opensolar/OpenOne/hall_pcb/HallPCB.JPG

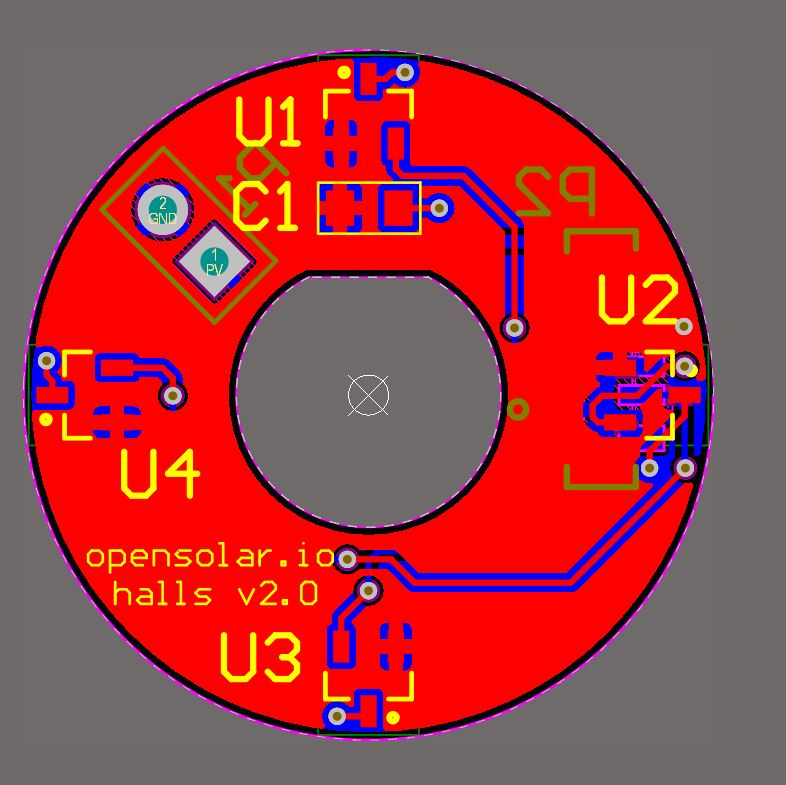
hall_pcb/HallPCB.JPG
