opensolar/OpenOne/main_pcb/alim_3.JPG

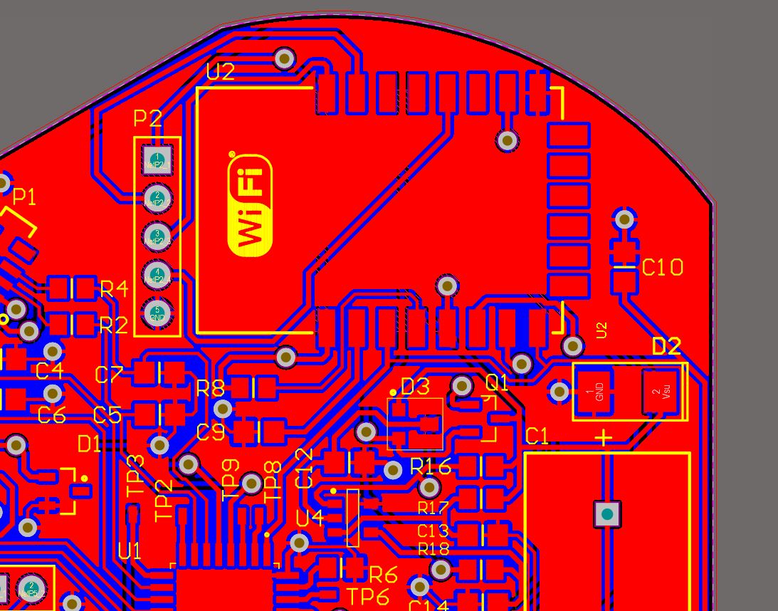
main_pcb/alim_3.JPG
