opensolar/OpenOne/ESP_firmware/openone_esp/readme.txt

setup arduino:

File/preferences:
Additional Board Manager URLS:https://arduino.esp8266.com/stable/package_esp8266com_index.json

Manage library:
ArduinoJson  (Benoit Blanchon 6.19.4)
PubSubClient (Nick O'Leary 2.8.0)

Créer un fichier credentials.h dans le meme dossier que le sketch:
//const char* ssid = "my_ssid";
//const char* password = "my_password";
//const char* mqtt_server = "technolaf.com:1883";
