opensolar/OpenOne/hall_pcb/HallPCB_3d.JPG

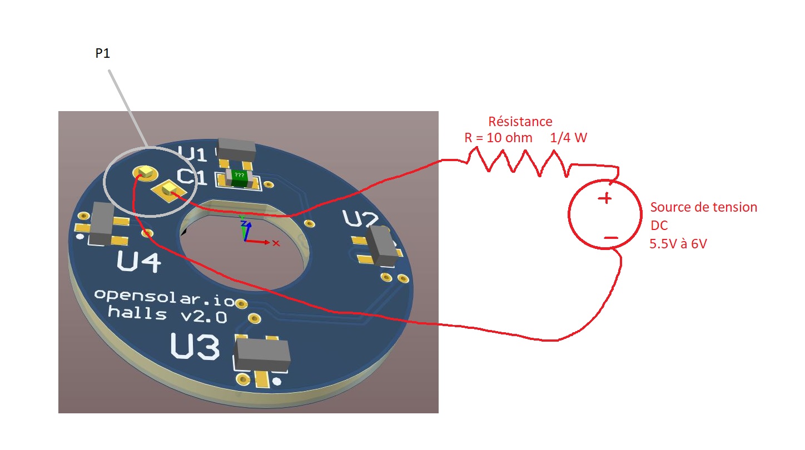
hall_pcb/HallPCB_3d.JPG
