opensolar/OpenOne/hall_pcb/HallPCB_supply.jpg

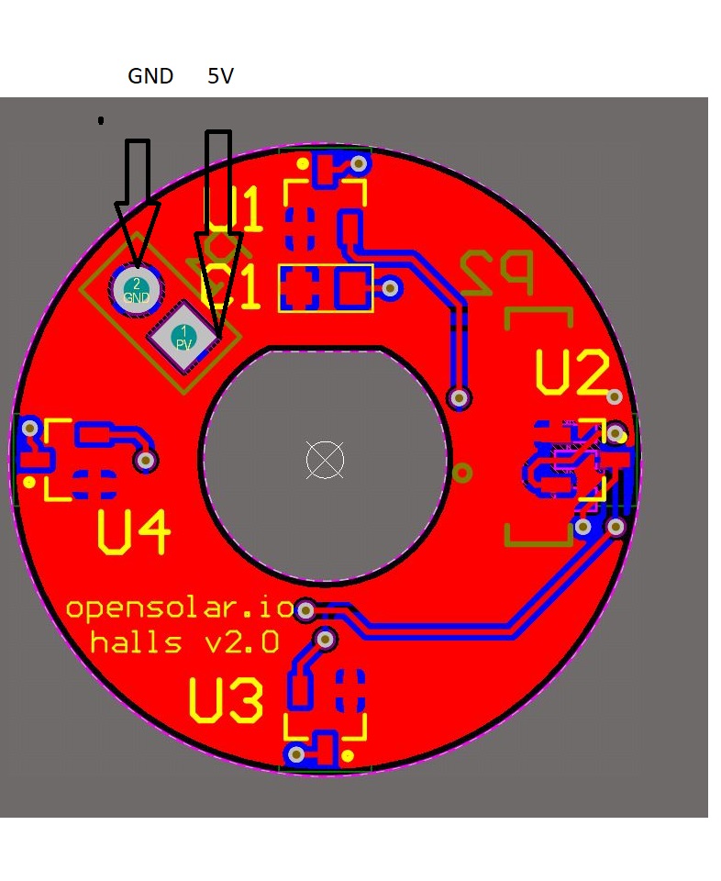
hall_pcb/HallPCB_supply.jpg
