opensolar/OpenOne/main_pcb/alim_1.JPG

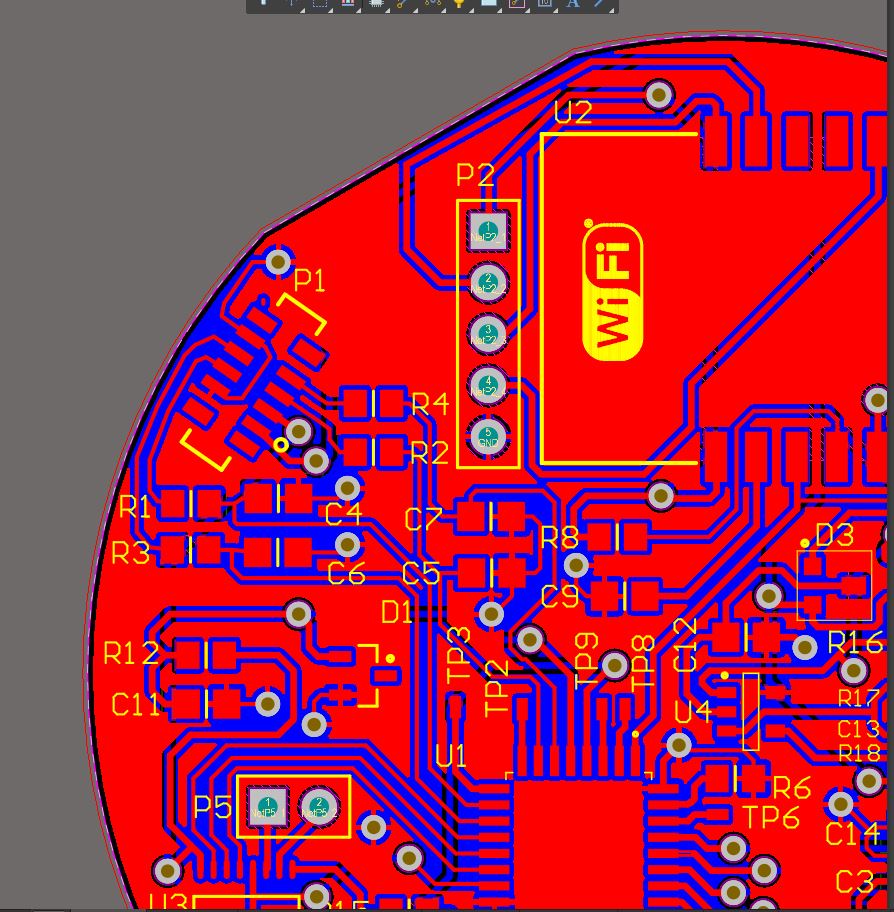
main_pcb/alim_1.JPG
