opensolar/OpenOne/main_pcb/alim_2.JPG

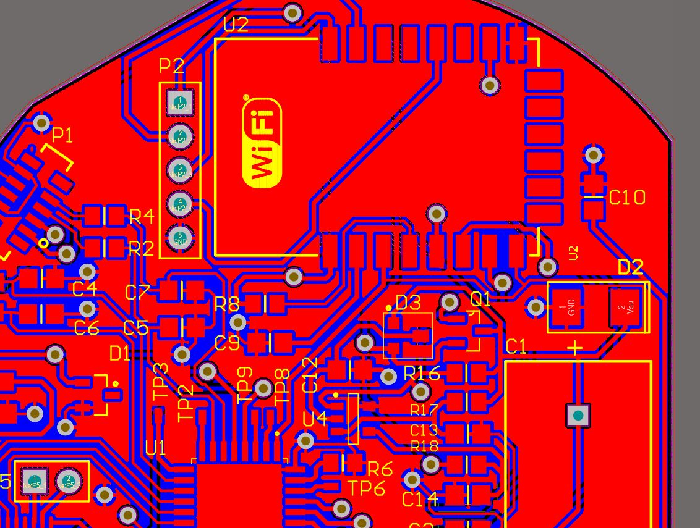
main_pcb/alim_2.JPG
