opensolar/OpenOne/main_pcb/alim_4.JPG

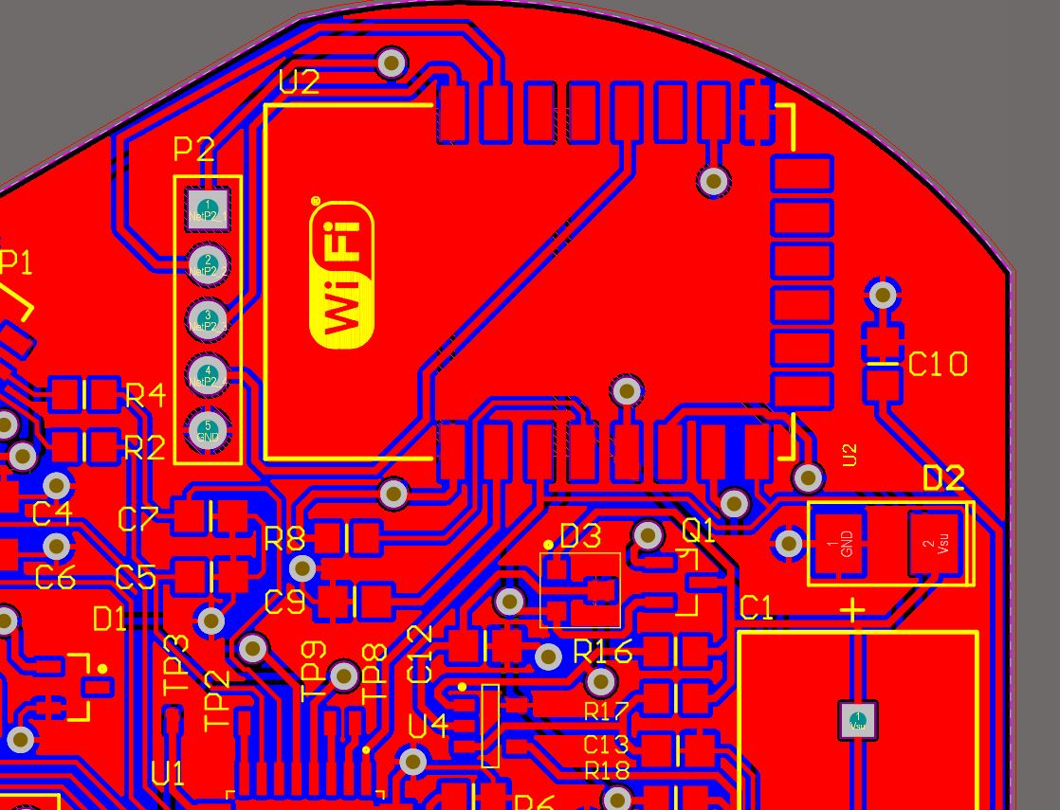
main_pcb/alim_4.JPG
