opensolar/OpenOne/main_pcb/esp12e.JPG

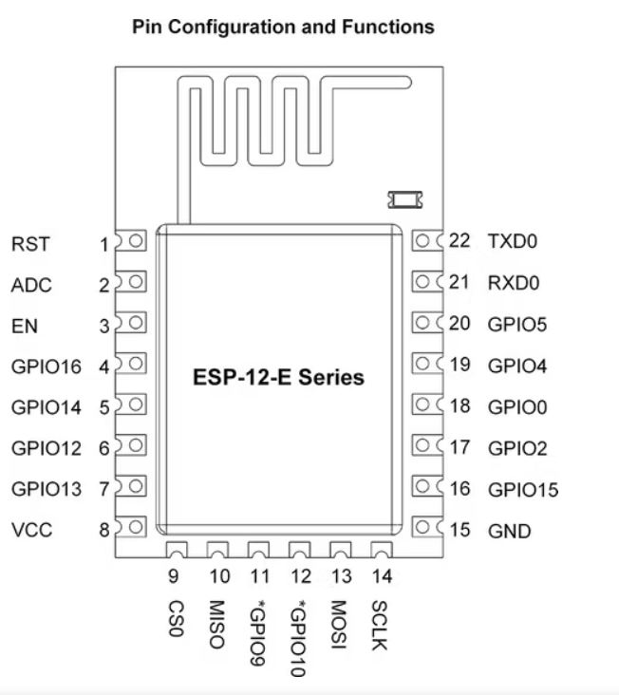
main_pcb/esp12e.JPG
