opensolar/OpenOne/main_pcb/MainPCB.JPG

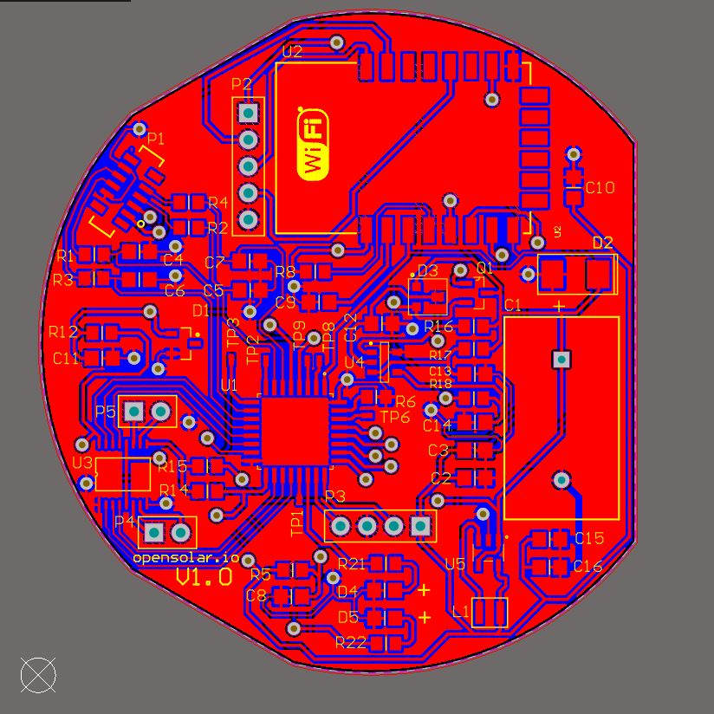
main_pcb/MainPCB.JPG
