opensolar/OpenOne/main_pcb/modif_motor_driver.PNG

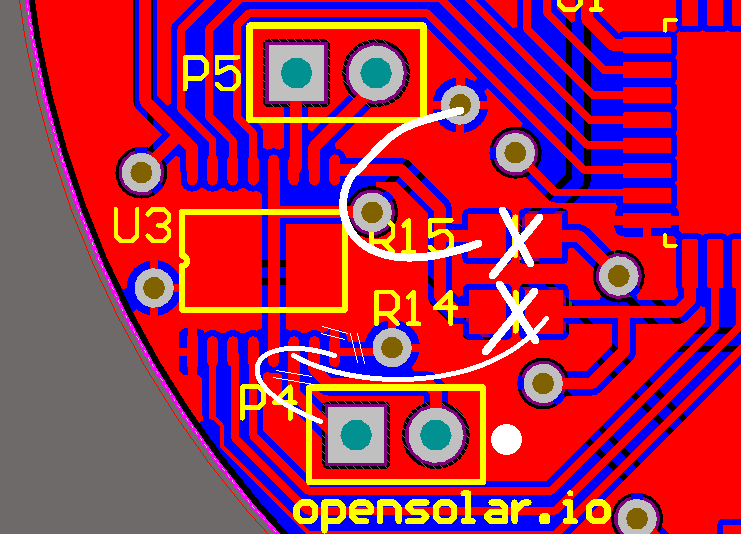
main_pcb/modif_motor_driver.PNG
