opensolar/OpenOne/main_pcb/modif_swap_ss_blueled.PNG

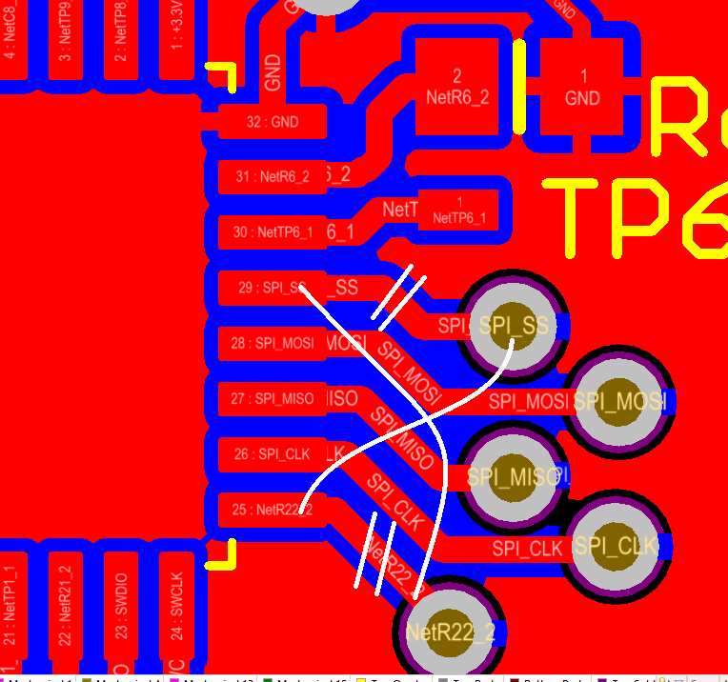
main_pcb/modif_swap_ss_blueled.PNG
