opensolar/OpenOne/main_pcb/STM32L011K4T6.JPG

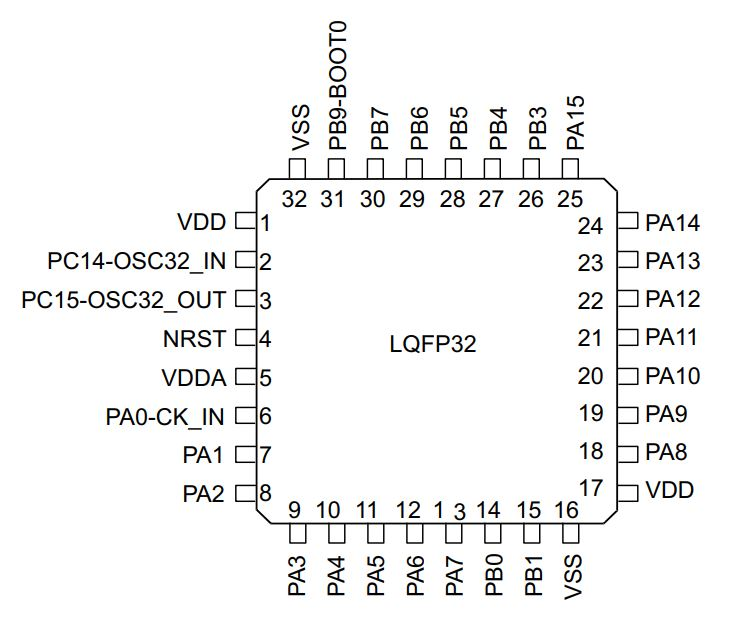
main_pcb/STM32L011K4T6.JPG
