opensolar/OpenOne/sun_angle_calculations/analemma_13h.png

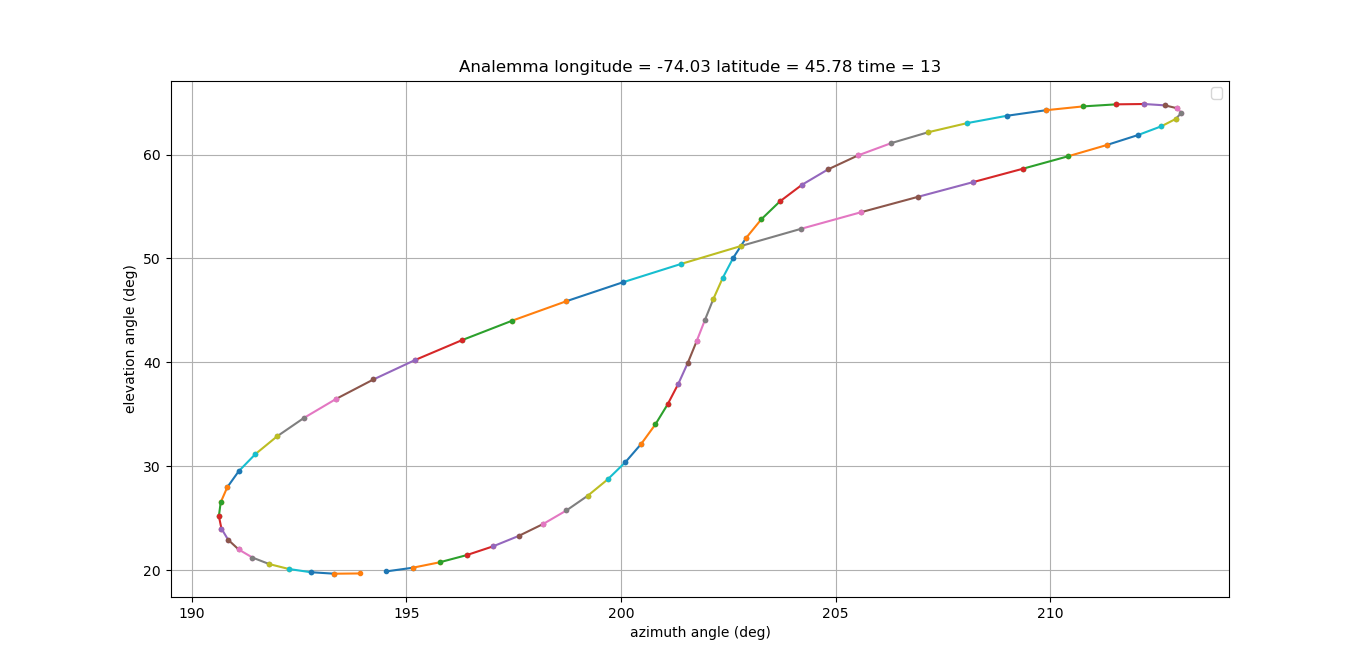
sun_angle_calculations/analemma_13h.png
