opensolar/OpenOne/sun_angle_calculations/analemma_different_cities.png

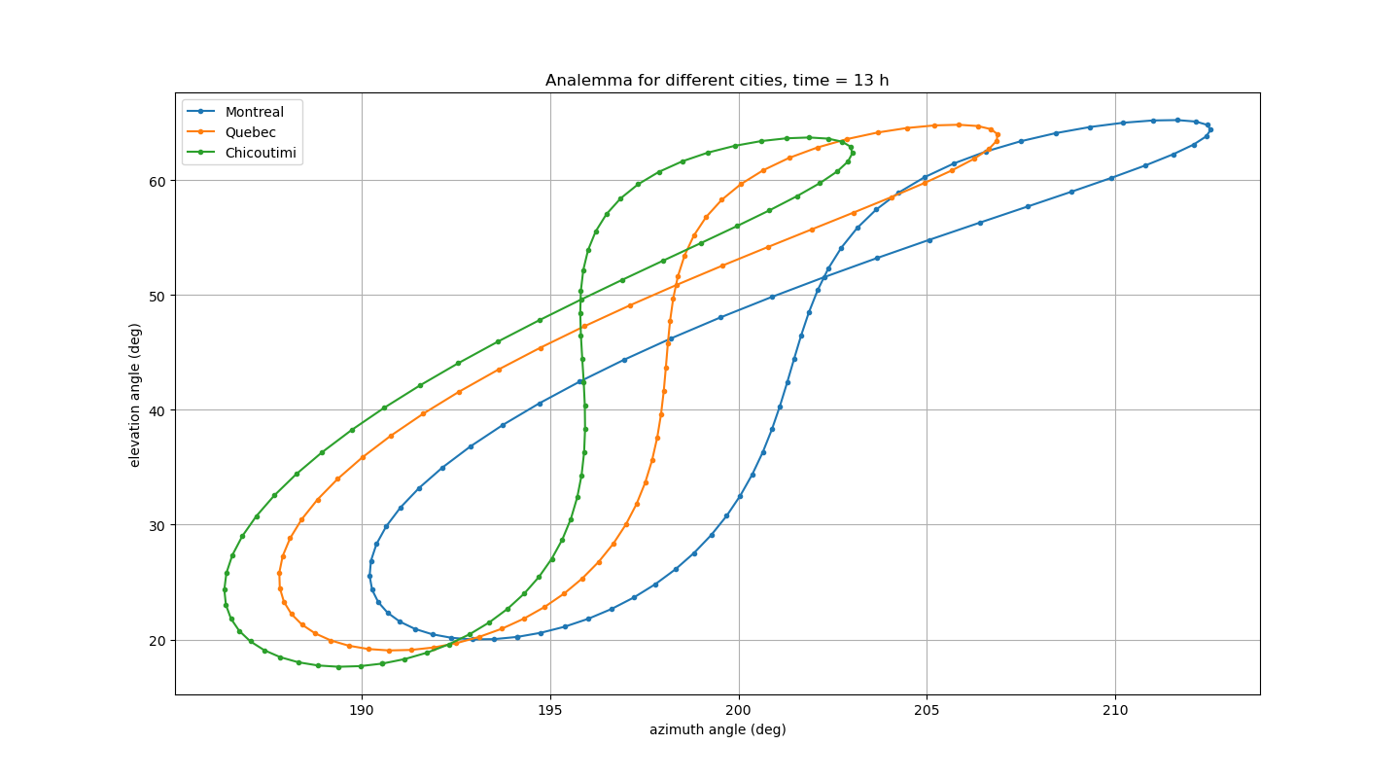
sun_angle_calculations/analemma_different_cities.png
