opensolar/OpenOne/sun_angle_calculations/declination_vs_days.png

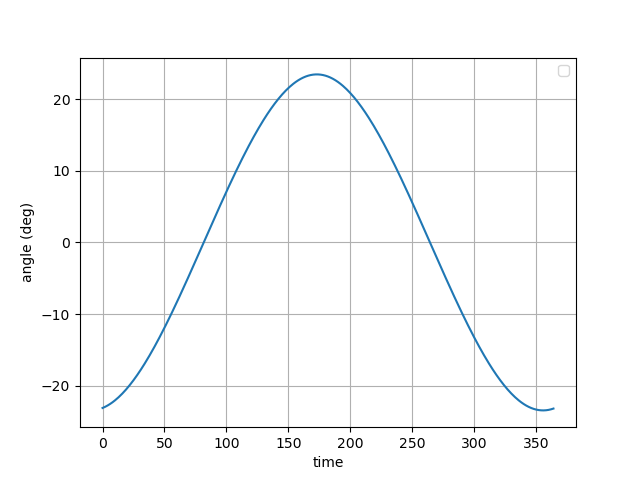
sun_angle_calculations/declination_vs_days.png
