opensolar/OpenOne/sun_angle_calculations/elevation_azimuth_isohour.png

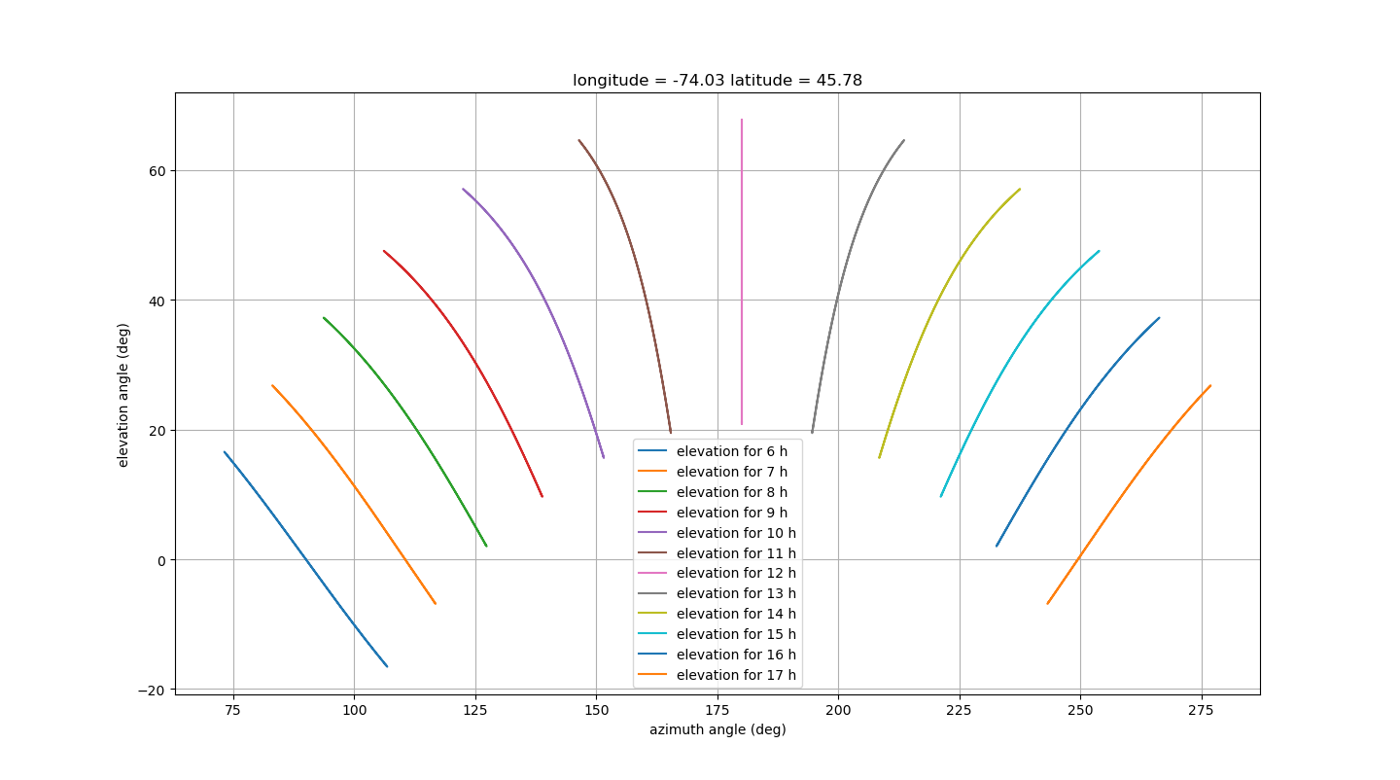
sun_angle_calculations/elevation_azimuth_isohour.png
