opensolar/OpenOne/sun_angle_calculations/elevation_vs_azimut.png

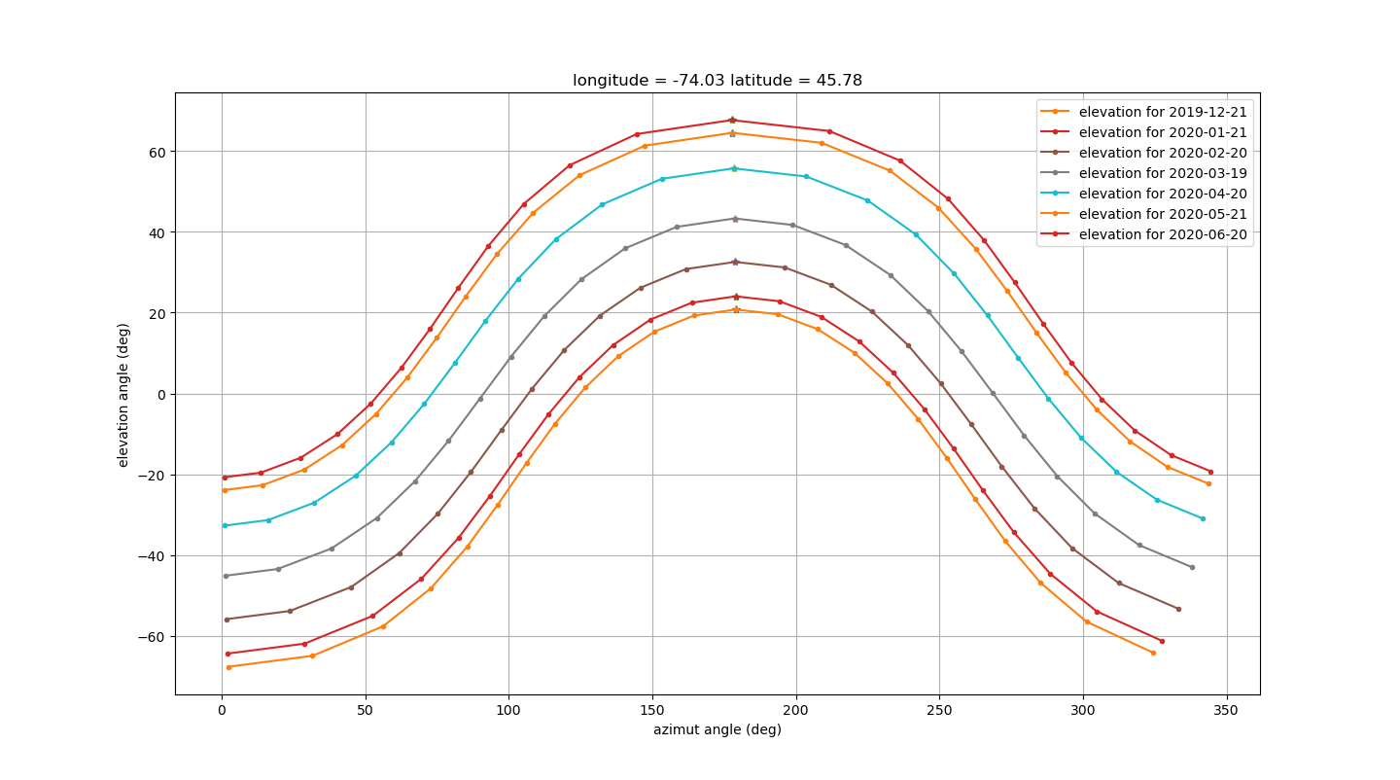
sun_angle_calculations/elevation_vs_azimut.png
