opensolar/OpenOne/sun_angle_calculations/elevation_vs_azimut_corrected.png

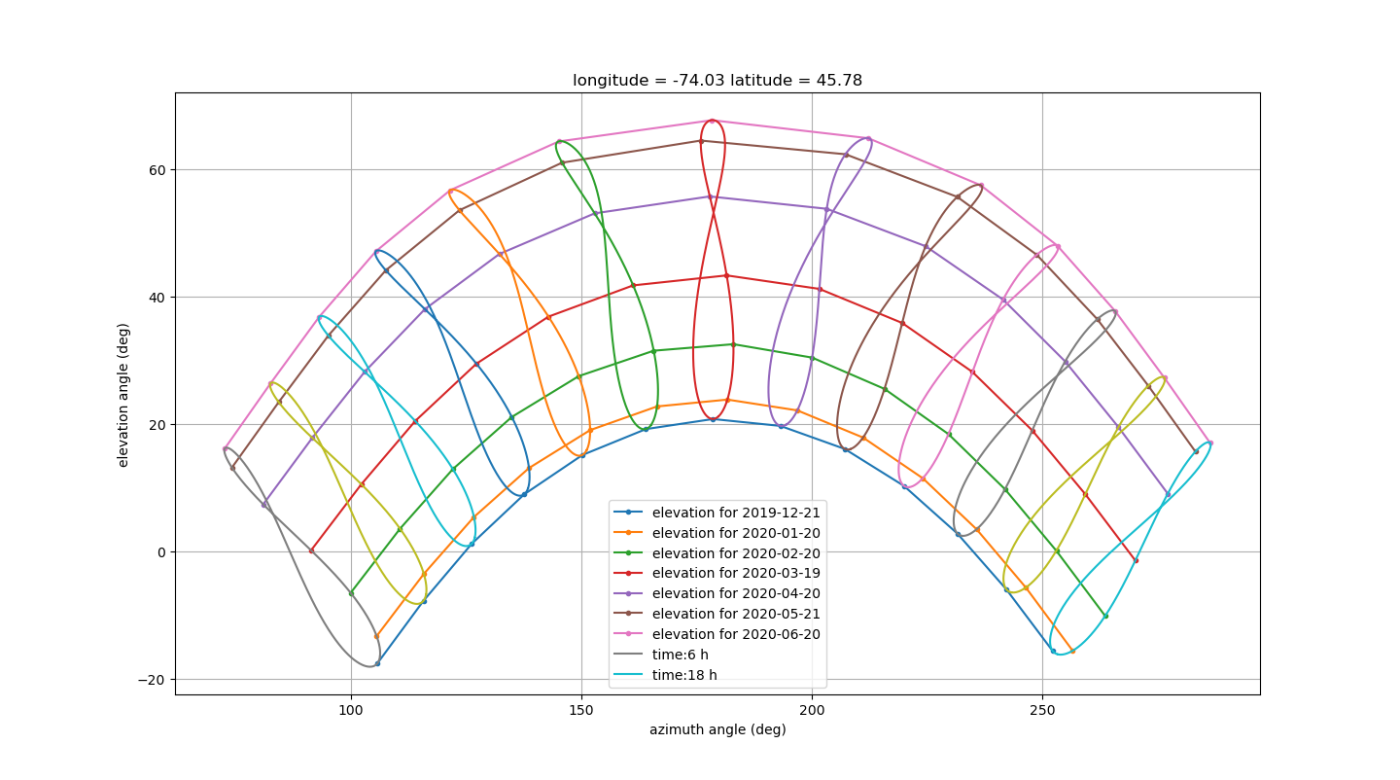
sun_angle_calculations/elevation_vs_azimut_corrected.png
