opensolar/OpenOne/sun_angle_calculations/elevation_vs_days_hours.png

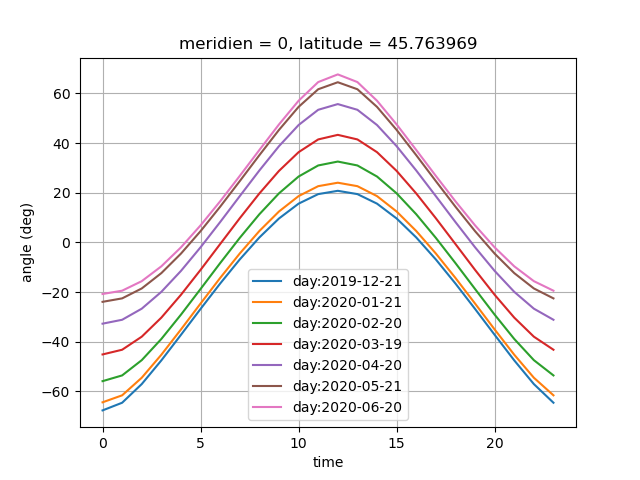
sun_angle_calculations/elevation_vs_days_hours.png
