opensolar/OpenOne/sun_angle_calculations/full_ivi.png

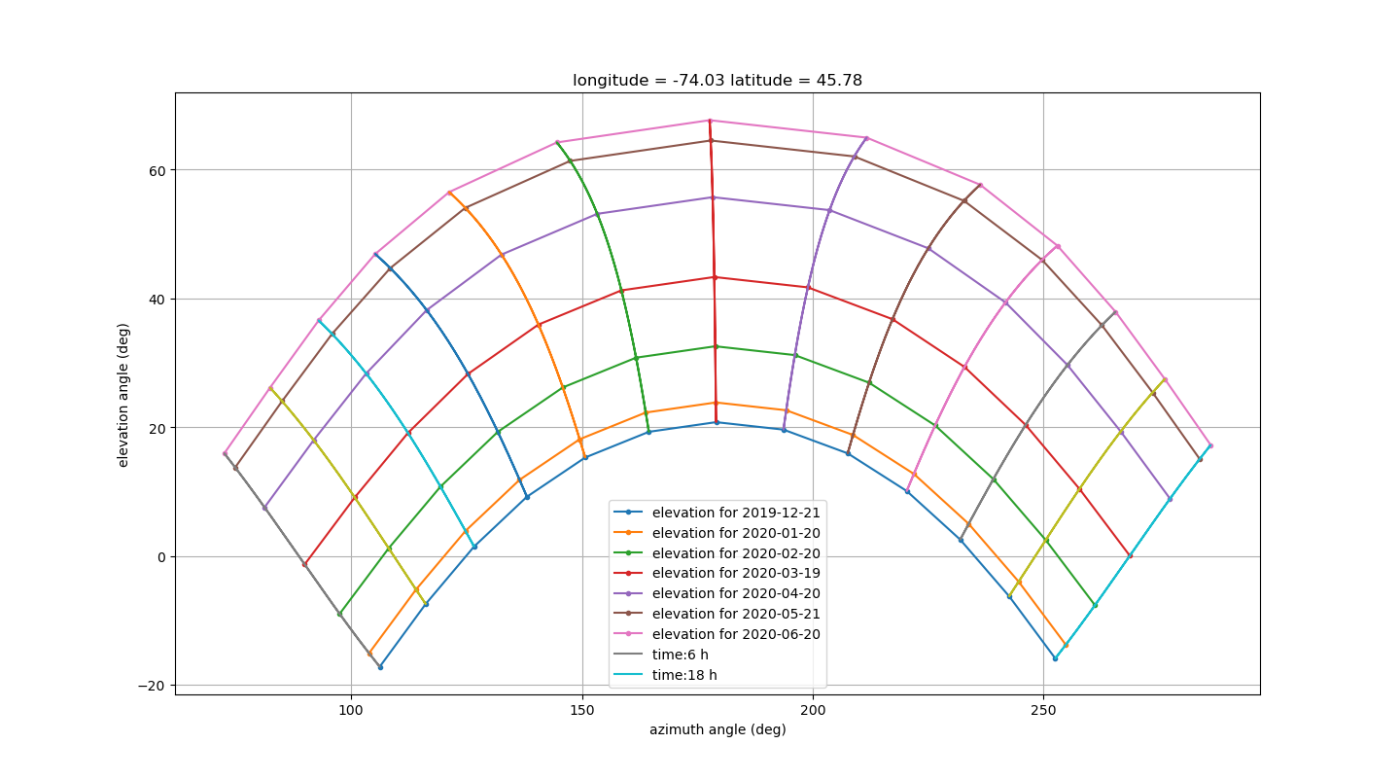
sun_angle_calculations/full_ivi.png
