opensolar/OpenOne/sun_angle_calculations/ivi_time_of_day.png

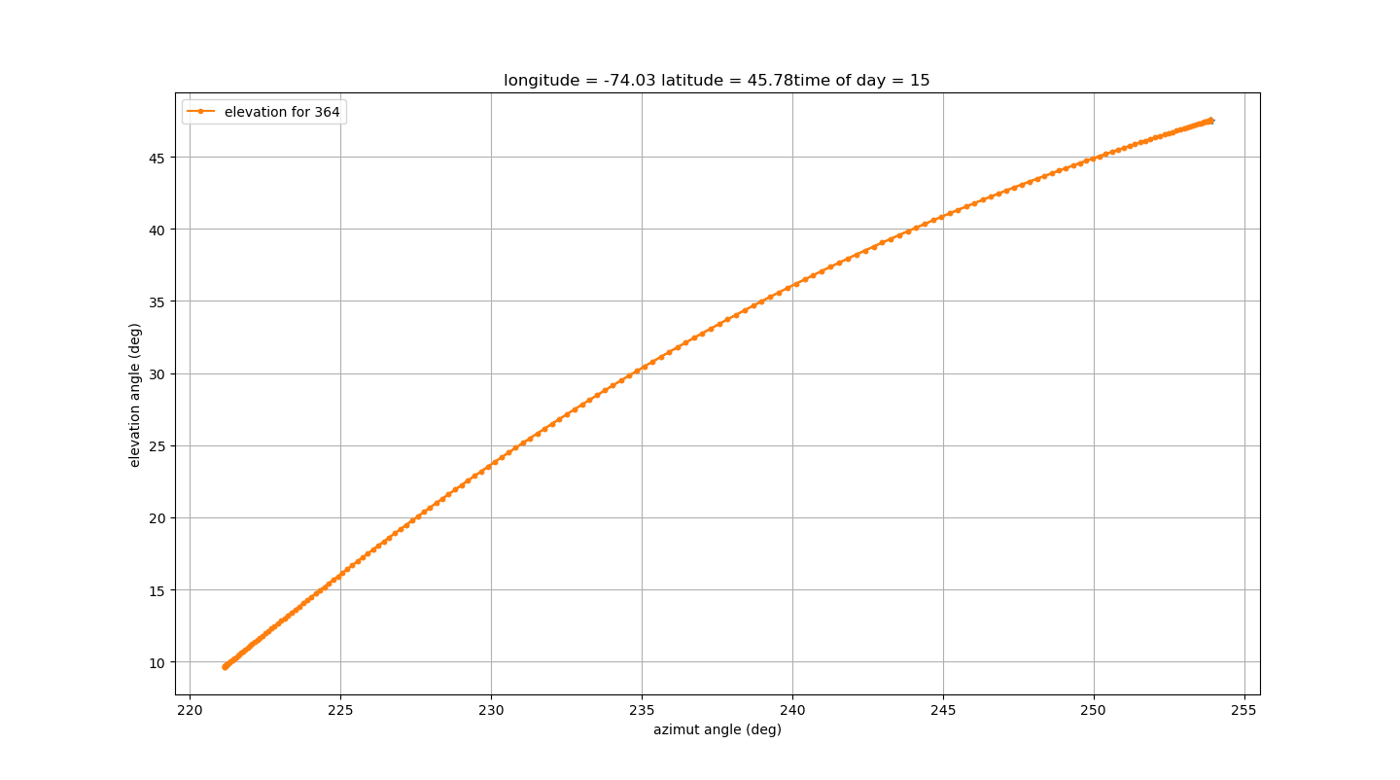
sun_angle_calculations/ivi_time_of_day.png
