opensolar/OpenOne/main_pcb/bom.xlsx

Comment | Designator | Footprint | jlc | Quantity | stock
Cap Pol1 | C1 | SCMR22H155PSBB0 |  | 1 | 1
1uF | C2, C3, C4, C5, C6, C7, C8, C9, C10, C11, C12, C13, C14, C16 | 6-0805_M | C28323 | 14
10uF | C15 | 6-0805_M | C15850 | 1
LM4040D30FTA | D1 | SOT23_LM4040 |  | 1 | 1
1SMB5918BT3G | D2 | SMB | C142361 | 1 | 1
BAT54CLT1G | D3 | SOT23-DUODIODE | C14308 | 1 | 1
RED | D4 | 6-0805_M | C72037 | 1 | 0 | 1
BLUE | D5 | 6-0805_M | C72035 | 1 | 1
CIGW252010GL4R7MNE | L1 | INDUCTOR_2520 - duplicate1 | C86070 | 1 | 1
Hall & PV | P1 | FFC_8 |  | 1 | 0 | 2
ESP serial | P2 | HEADER-1X5 |  | 1 | 1
ST-LINK | P3 | HEADER-1X4 |  | 1 | 1
roll motor | P4 | HEADER-1X2 |  | 1 | 1
pitch motor | P5 | HEADER-1X2 |  | 1 | 1
PMV35EPER | Q1 | PMV35EPER |  | 1 | 1
10K | R1, R2, R3, R4, R5, R6, R17, R18 | 6-0805_N | C17414 | 8
3.3K | R8 | 6-0805_N | C26010 | 1
33R | R12 | 6-0805_N | C17634 | 1
0R | R14 | 6-0805_N | C17477 | 1
10M | R15 | 6-0805_N | C26108 | 1
1K | R16 | 6-0805_N | C17513 | 1
47R | R21, R22 | 6-0805_N | C17714 | 2
TEST_POINT | TP1, TP2, TP3, TP6, TP8, TP9 | TEST_POINT_PAD |  | 6
STM32L011K4T6 | U1 | QFP80P900X900X160-32N | C87904 | 1
ESP8266 ESP-12-E | U2 | ESP8266 ESP-12-E |  | 1
TB6652PNG | U3 | SSOP16_TB6652 |  | 1 | 1
MIC7221YM5 | U4 | MIC7221YM5 |  | 1 | 1
PAM2301CAAB330 | U5 | SOT95P280X100-5N | C9051 | 1 | 1
