opensolar/OpenOne/hall_pcb/hall5.step

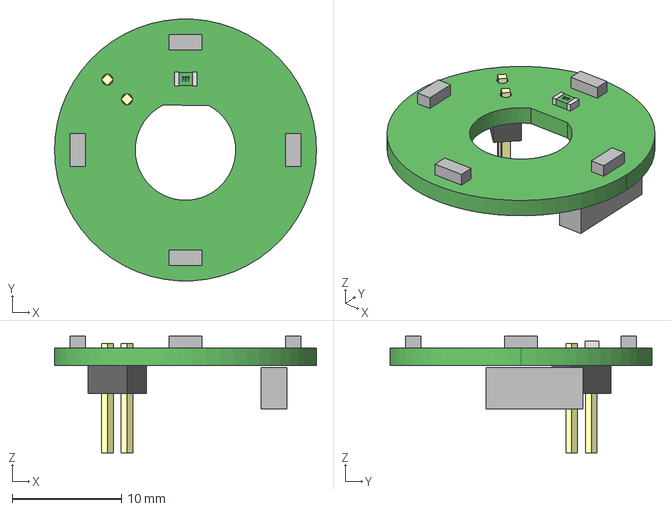
[picture p22: CAD file, 2021-02-20]
hall_pcb/hall5.step
24.0 x 24.0 x 10.7 mm
Board
Extruded x 18
