opensolar/OpenOne/hall_pcb/hall2.step

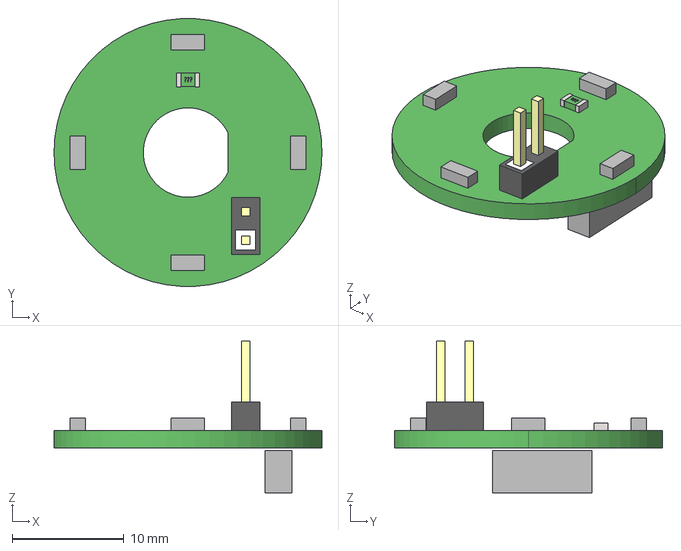
[picture p23: CAD file, 2020-11-30]
hall_pcb/hall2.step
24.0 x 24.0 x 13.6 mm
Board
Extruded x 18
