opensolar/OpenOne/(list of files, cad)

Other CAD files:
hall_pcb/hall3.step
hall_pcb/hall4.step
hall_pcb/hall.step
