opensolar/OpenOne/main_pcb/Main.pdf

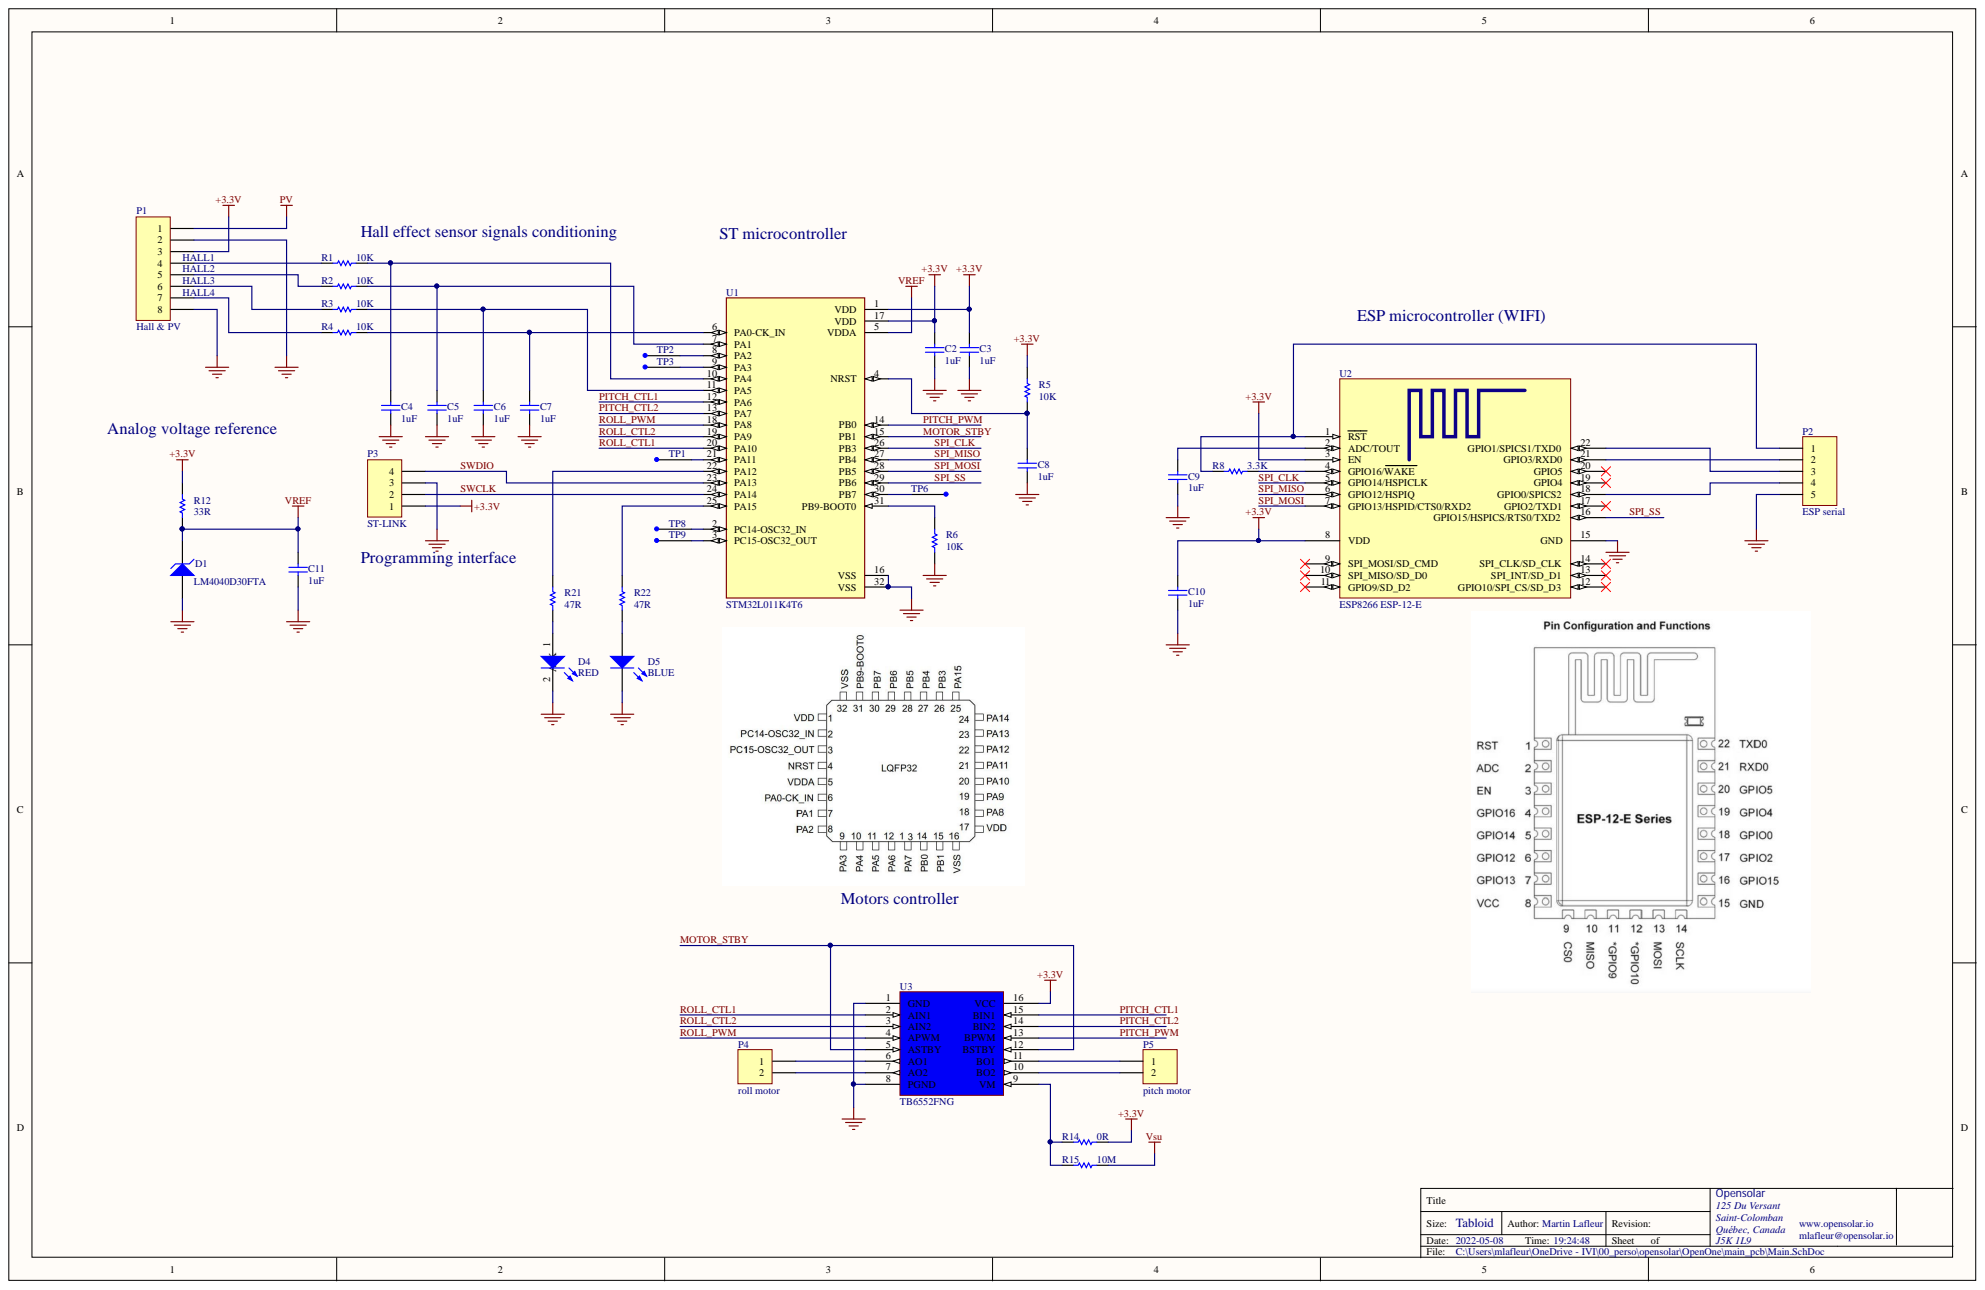
[picture p24: page 1]

Hall effect sensor signals conditioning

HALL2
HALL3
HALL4

Title | Opensolar 125 Du Versant Saint-Colomban Québec, Canada www.opensolar.io mlafleur@opensolar.io J5K 1L9

Size: Tabloid | Author: Martin Lafleur | Revision:

Date: 2022-05-08 Time: 19:24:48 | | Sheet of

C:\Users\mlafleur\OneDrive - IVI\00_perso\opensolar\OpenOne\main_pcb\Main.SchDoc

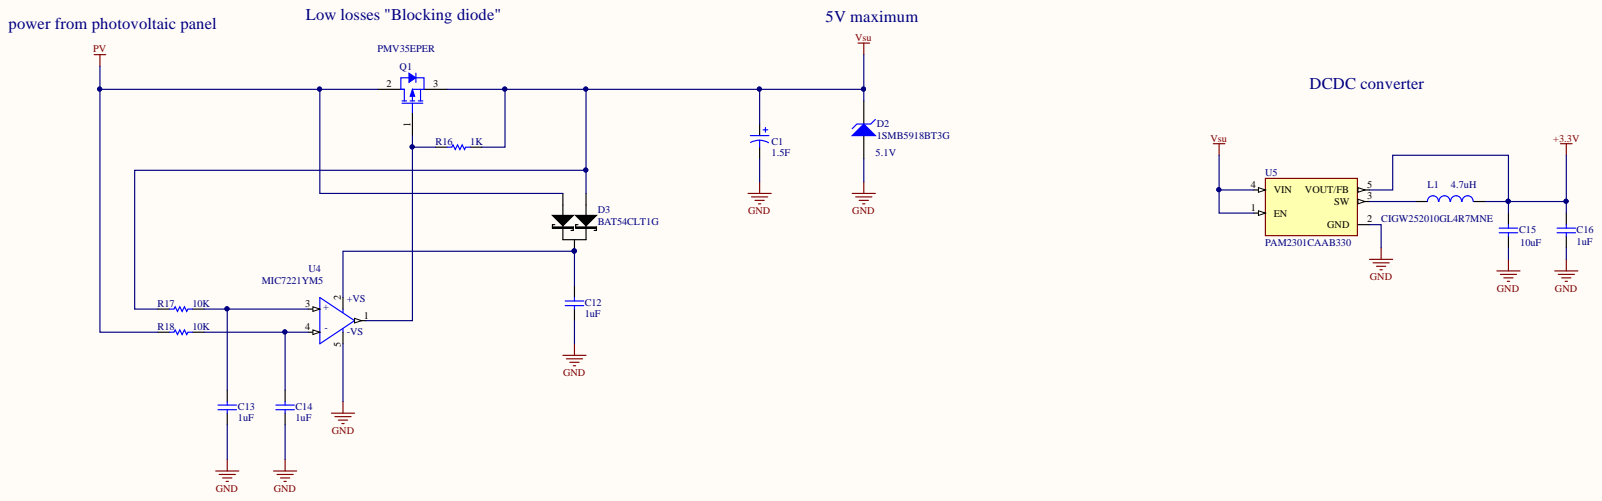
[picture p25: page 2]

U4 MIC7221YM5 R17 10K

Title | O pensolar 125 Du Versant Saint-Colomban Qu ébec, Canada www .opensolar .io mlafleur@opensolar .io J5K 1L9

Size: Tabloid | Author: Martin Lafleur | Revision:

Date: 2022-05-08 Time: 19:24:48 | | Sheet of

C:\Users\mlafleur\OneDrive - IVI\00_perso\opensolar\OpenOne\main_pcb\power
