opensolar/OpenOne/hall_pcb/hall.pdf

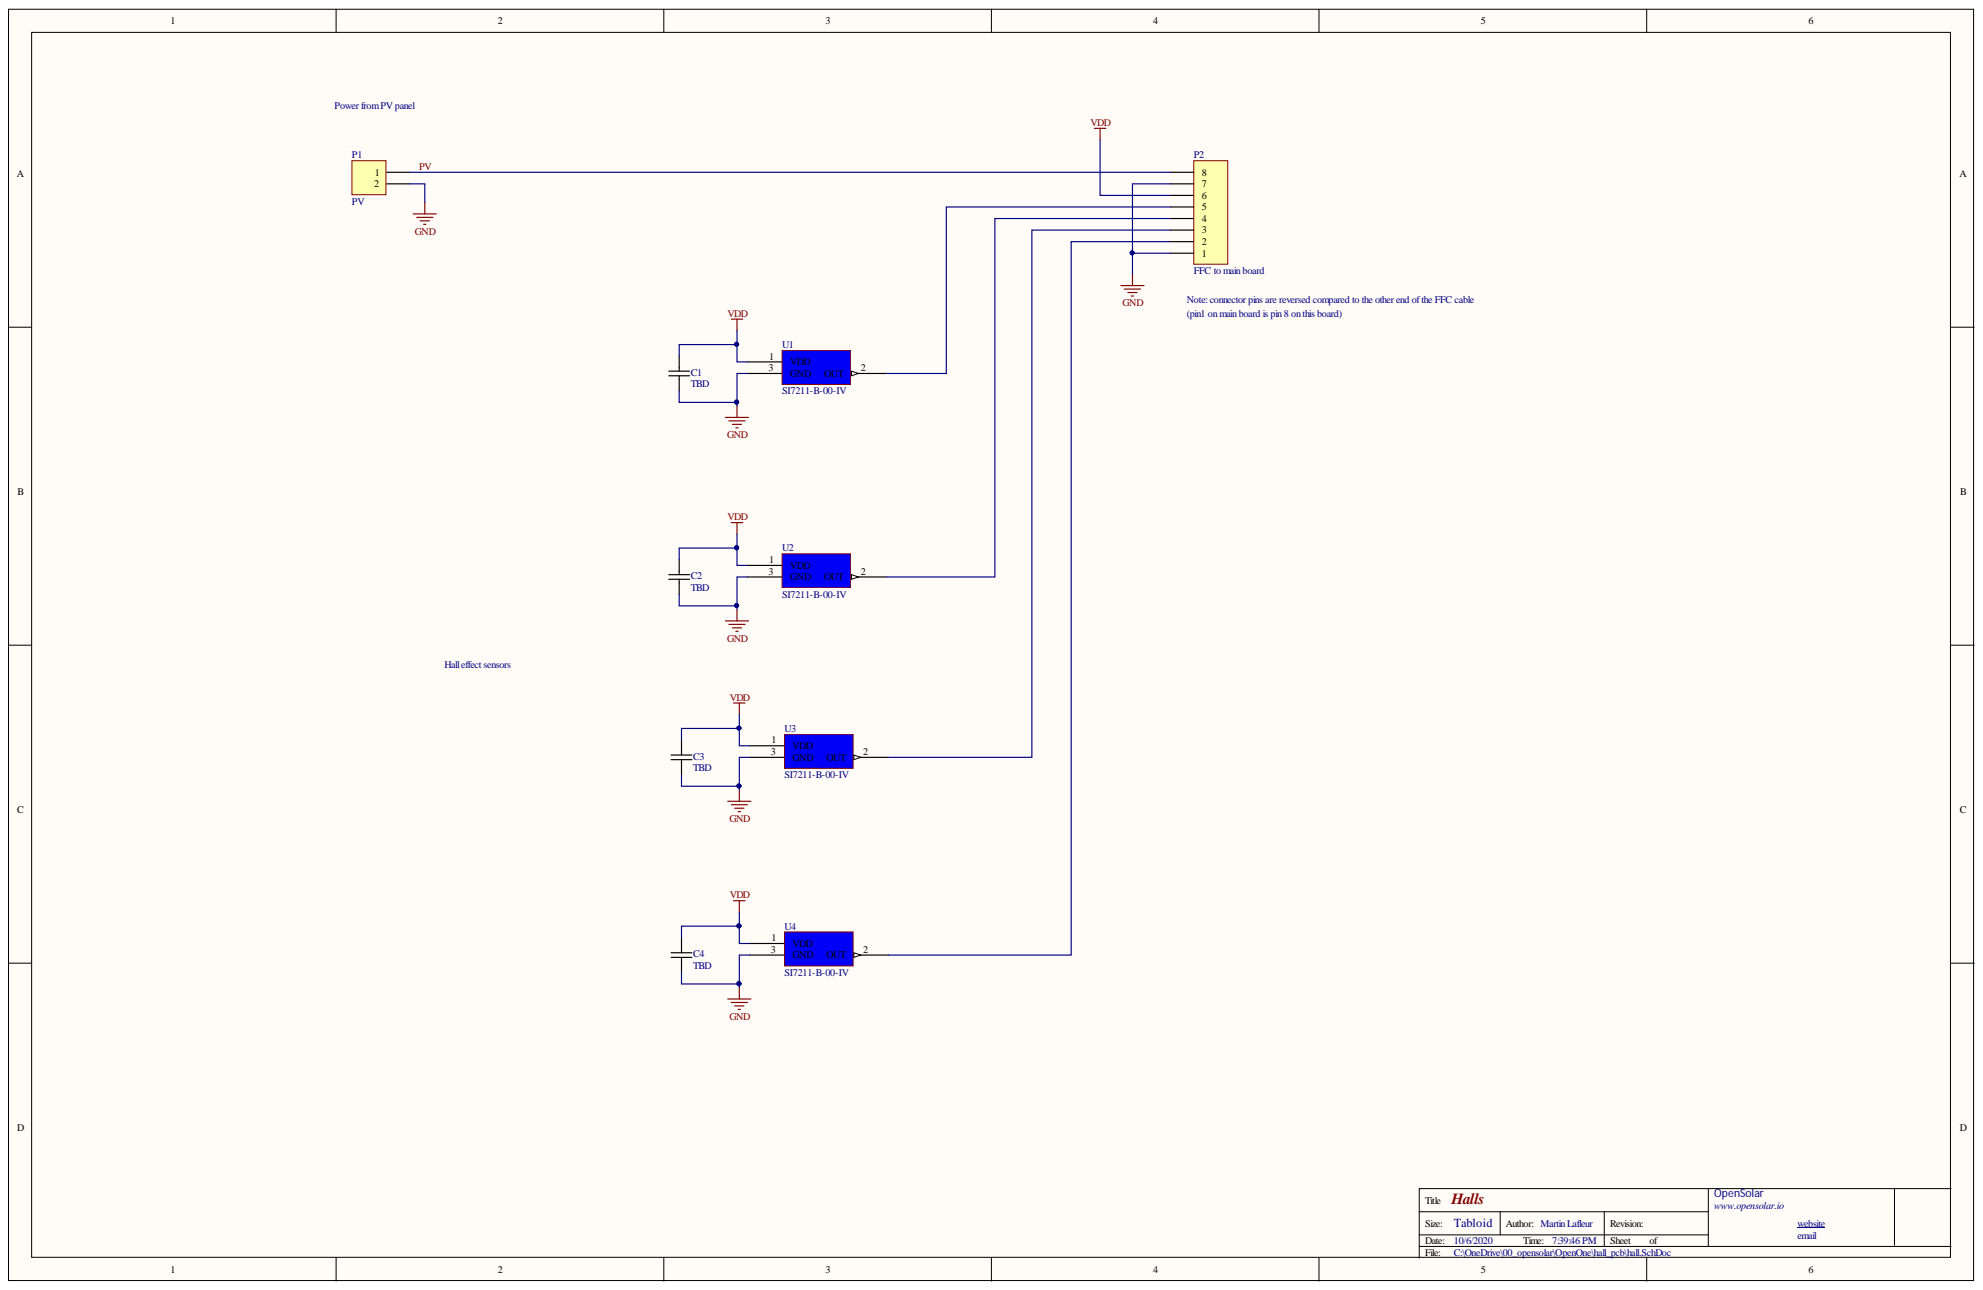
[picture p26: page 1]

FFC to main board

Note: connector pins are reversed compared to the other end ofthe FFC cable
(pin1 onmain board is pin 8 on this board)

Title | OpenSolar H www.opensolar.io alls website email

Tabloid Size: | MartinLafleur Author: | Revision:

Date: 10/6/2020 Time: 7:39:46 PM | | Sheet of
File: C:\OneDrive\00_opensolar\OpenOne\hall_pcb\hall.SchDoc
