opensolar/OpenOne/(list of files, drawings)

Other design files:
hall_pcb/hall.PcbDoc
hall_pcb/Hall.PrjPcb
hall_pcb/hall.SchDoc
main_pcb/Main.PcbDoc
main_pcb/Main.PrjPcb
main_pcb/Main.SchDoc
main_pcb/power.SchDoc
