opensolar/OpenOne/STM_firmware/Core/Src/main.c

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
/* Includes ------------------------------------------------------------------*/
#include "main.h"

/* USER CODE BEGIN Includes */
#include <string.h>
#include "motor.h"
/* USER CODE END Includes */

ADC_HandleTypeDef hadc;
DMA_HandleTypeDef hdma_adc;

SPI_HandleTypeDef hspi1;
DMA_HandleTypeDef hdma_spi1_rx;
DMA_HandleTypeDef hdma_spi1_tx;

TIM_HandleTypeDef htim2;

/* USER CODE BEGIN PV */
bool communication_ok = false;

uint8_t spi_tx_data[sizeof(SPI_TX_FRAME)];
SPI_TX_FRAME txFrame;

uint8_t spi_rx_data[sizeof(SPI_RX_FRAME)];
uint32_t spi_rx_count;
SPI_RX_FRAME rxFrame;

#define NB_ADC_CHANNELS  4

uint16_t adc_buffer[NB_ADC_CHANNELS];
uint16_t adc_filtered[NB_ADC_CHANNELS];

// Sensor  Hall(P2)  Main(P1)  PortA   ADC
//          pin#      pin#
// U1       5         4         4       2
// U2       4         5         1       1
// U3       3         6         5       3
// U4       2         7         0       0



#define HALL1 0
#define HALL2 1
#define HALL3 3
#define HALL4 0







/* USER CODE END PV */

void SystemClock_Config(void);
static void MX_GPIO_Init(void);
static void MX_DMA_Init(void);
static void MX_ADC_Init(void);
static void MX_TIM2_Init(void);
static void MX_SPI1_Init(void);
/**
  * @brief  The application entry point.
  * @retval int
  */
int main(void)
{
  /* MCU Configuration--------------------------------------------------------*/

  /* Reset of all peripherals, Initializes the Flash interface and the Systick. */
  HAL_Init();

  /* Configure the system clock */
  SystemClock_Config();

  /* Initialize all configured peripherals */
  MX_GPIO_Init();
  MX_DMA_Init();
  MX_ADC_Init();
  MX_TIM2_Init();
  MX_SPI1_Init();
  /* USER CODE BEGIN 2 */


  HAL_ADC_Start_DMA(&hadc, (uint32_t*)adc_buffer, NB_ADC_CHANNELS); // Start ADC in DMA

  txFrame.hall[0] = 10;
  txFrame.hall[1] = 1000;
  txFrame.hall[2] = 10000;
  txFrame.hall[3] = 0xffff;
  txFrame.status = 0xcafe;
  memcpy(spi_tx_data, &txFrame, sizeof(SPI_TX_FRAME));

  setPWM(TIM_CHANNEL_1, 32000, 32767);
  setPWM(TIM_CHANNEL_2, 32000, 8000);

  //while(HAL_GPIO_ReadPin(GPIOA, GPIO_PIN_15) != GPIO_PIN_SET); // CS signal

  //while(HAL_SPI_GetState(&hspi1) == HAL_SPI_STATE_BUSY_TX_RX);
  HAL_SPI_TransmitReceive_DMA(&hspi1, spi_tx_data, spi_rx_data, sizeof(SPI_RX_FRAME));


  /* USER CODE END 2 */

  /* Infinite loop */
  /* USER CODE BEGIN WHILE */


  //HAL_GPIO_WritePin(MOTOR_STBY_GPIO_Port, MOTOR_STBY_Pin, GPIO_PIN_SET);

  // show the system reset by blinking the blue led fast
  for(int i = 0; i < 10 ; i++){
    HAL_GPIO_TogglePin(BLUE_LED_GPIO_Port, BLUE_LED_Pin);
    HAL_Delay(100);
  }


  while (1)
  {


    /* USER CODE END WHILE */

    /* USER CODE BEGIN 3 */
    HAL_GPIO_TogglePin(BLUE_LED_GPIO_Port, BLUE_LED_Pin);


    communication_ok = false;
    HAL_Delay(500);

    if(!communication_ok){
      enable_motors(false);
    } else if(!(rxFrame.control.bits & RUN)){
      enable_motors(false);

    } else {
      enable_motors(true);
      drive_roll_motor(&rxFrame.motor[0]);
      drive_pitch_motor(&rxFrame.motor[1]);
    }
/*
    if(rxFrame.control.bits & RED_LED){
      HAL_GPIO_WritePin(RED_LED_GPIO_Port, RED_LED_Pin, GPIO_PIN_SET);
    } else {
      HAL_GPIO_WritePin(RED_LED_GPIO_Port, RED_LED_Pin, GPIO_PIN_RESET);
    }
*/

  }
  /* USER CODE END 3 */
}

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
/* USER CODE BEGIN 4 */

void setPWM(uint32_t channel, uint16_t period, uint16_t pulse){
 HAL_TIM_PWM_Stop(&htim2, channel); // stop generation of pwm
 TIM_OC_InitTypeDef sConfigOC;
 htim2.Init.Period = period; // set the period duration
 HAL_TIM_PWM_Init(&htim2); // reinititialise with new period value
 sConfigOC.OCMode = TIM_OCMODE_PWM1;
 sConfigOC.Pulse = pulse; // set the pulse duration
 sConfigOC.OCPolarity = TIM_OCPOLARITY_HIGH;
 sConfigOC.OCFastMode = TIM_OCFAST_DISABLE;
 HAL_TIM_PWM_ConfigChannel(&htim2, &sConfigOC, channel);
 HAL_TIM_PWM_Start(&htim2, channel); // start pwm generation
}


void HAL_SPI_TxRxCpltCallback(SPI_HandleTypeDef *hspi){
  static uint8_t  lastWatchdog = 0;
  if(hspi->Instance == SPI1){
    spi_rx_count++;

    memcpy((void *)&rxFrame, (void *)spi_rx_data, sizeof(SPI_RX_FRAME));

    // copy tx data
    txFrame.hall[0] = adc_filtered[0];
    txFrame.hall[1] = adc_filtered[1];
    txFrame.hall[2] = adc_filtered[2];
    txFrame.hall[3] = adc_filtered[3];
    txFrame.status = 0;
    memcpy(spi_tx_data, &txFrame, sizeof(SPI_TX_FRAME));


    // initialize lastWachdog only at startup
    if(lastWatchdog == 0 && (rxFrame.control.watchdog == 0x55 || rxFrame.control.watchdog == 0xAA)){
      lastWatchdog = rxFrame.control.watchdog == 0x55 ? 0xAA : 0x55;
    }

    if(rxFrame.control.watchdog == 0x55){
      communication_ok = lastWatchdog == 0xAA;
      lastWatchdog = rxFrame.control.watchdog;
    } else if(rxFrame.control.watchdog == 0xAA){
      communication_ok = lastWatchdog == 0x55;
      lastWatchdog = rxFrame.control.watchdog;
    } else {
      // data is not in sync, reset STM
      communication_ok = false;
      NVIC_SystemReset();
    }

    // uncomment when not circular mode
    //while(HAL_SPI_GetState(hspi) == HAL_SPI_STATE_BUSY_TX_RX);
    //if(HAL_SPI_TransmitReceive_DMA(hspi, spi_tx_data, spi_rx_data, sizeof(SPI_RX_FRAME)) != HAL_OK){
    //  Error_Handler();
    //}



  }
}

void HAL_SPI_ErrorCallback(SPI_HandleTypeDef *hspi){
  if(hspi->Instance == SPI1){
    //while(HAL_SPI_GetState(&hspi1) == HAL_SPI_STATE_BUSY_TX_RX);
    //HAL_SPI_TransmitReceive_DMA(&hspi1, spi_tx_data, spi_rx_data, sizeof(SPI_RX_FRAME));

    Error_Handler();

  }

}


void HAL_ADC_ConvCpltCallback(ADC_HandleTypeDef* hadc){
  // Measured 348us
  // TAU = 1ms, T = 348us
  // K = exp(-T / TAU)
  const uint32_t K = (uint32_t)(0.95 * 256);
  //HAL_GPIO_TogglePin(RED_LED_GPIO_Port, RED_LED_Pin);

  for(int i = 0; i < NB_ADC_CHANNELS; i++){
    uint32_t f = ((uint32_t)adc_buffer[i] * (256UL - K) + K * adc_filtered[i]);
    adc_filtered[i] = (uint16_t)(f / 256UL) + (((f % 256) >= 128) ? 1 : 0);   // round the value

    // int instead of round:
    // adc_filtered[i] = (uint16_t)(((uint32_t)adc_buffer[i] * (256UL - K) + K * adc_filtered[i]) / 256UL);
  }

}


/* USER CODE END 4 */
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
