opensolar/OpenOne/STM_firmware/OpenOne.ioc

PA0-CK_IN.GPIO_Label=HALL4
Mcu.UserName=STM32L011K4Tx
PB6.GPIO_Label=BLUE_LED
PB0.GPIO_Label=PITCH_PWM
PA6.GPIO_Label=PITCH_CTL1
PA12.Signal=GPIO_Output
PB6.Signal=GPIO_Output
PA0-CK_IN.Signal=ADC_IN0
PB1.GPIO_Label=MOTOR_STBY
PA10.GPIO_Label=ROLL_CTL1
PA8.Signal=S_TIM2_CH1
PA6.Signal=GPIO_Output
PB1.Signal=GPIO_Output
PA10.Signal=GPIO_Output
PA15.Signal=SPI1_NSS
PA4.GPIO_Label=HALL1
PB4.Signal=SPI1_MISO
PA9.GPIO_Label=ROLL_CTL2
PA12.GPIO_Label=RED_LED
PA13.Signal=SYS_SWDIO
PA8.GPIO_Label=ROLL_PWM
PA9.Signal=GPIO_Output
PA1.Signal=ADC_IN1
PA5.Signal=ADC_IN5
PA1.GPIO_Label=HALL2
PB3.Signal=SPI1_SCK
PA4.Signal=ADC_IN4
PB5.Signal=SPI1_MOSI
PA7.GPIO_Label=PITCH_CTL2
PA5.GPIO_Label=HALL3
PA14.Signal=SYS_SWCLK
PB0.Signal=S_TIM2_CH2
PA7.Signal=GPIO_Output
