opensolar/OpenOne/(commit log)

2020-09-20 added ESP MQTT layer
    [Main.DWG, Main.DXF, Main.PrjPcb, Main.SchDoc, Main.step, Main.x_t, Main.xlsx, mppt.SchDoc]
2020-09-26 added hall pcb
    [Hall.PrjPcb, Main.SchDoc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]
2020-10-10 generated pdf files
    [Main.SchDoc]
2020-10-10 updated schematic pdf
2020-10-19 added nodejs app
    [Hall.PrjPcb, Main.PrjPcb, Main.SchDoc, power.SchDoc]
2020-11-15 modified web app to change motor speed and to use keyboard arrows
2021-02-20 halls pcb fix + sofware update
    [Hall.PrjPcb, Main.SchDoc, calculs_firmware.xlsx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]
