opensolar/OpenOne/(notices)

Notices in the files:
STM_firmware/Core/Src/main.c:
Copyright 2020 opensolar.io
(C) COPYRIGHT STMicroelectronics *****END OF FILE
